zhangjinke/J-Link-OB-RA4M2/Photos/IMG_20231012_173926.jpg

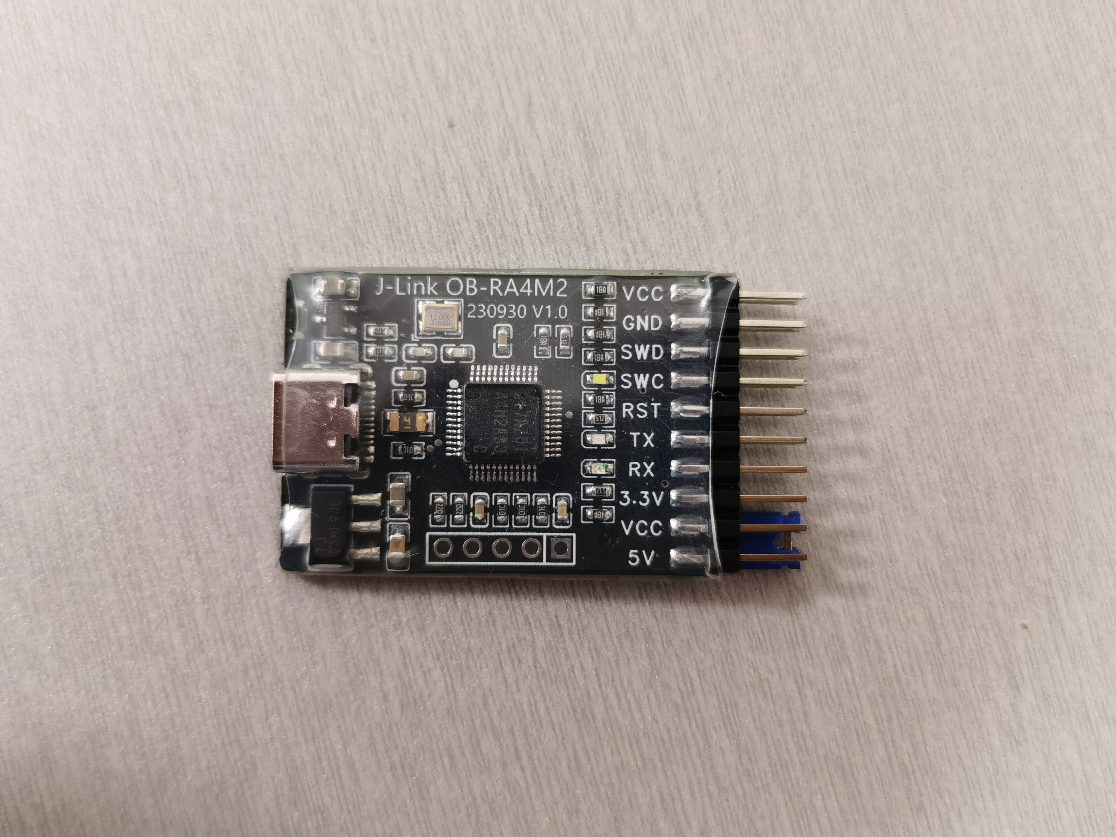
Photos/IMG_20231012_173926.jpg
