zhangjinke/J-Link-OB-RA4M2/README.md

# 简介
J-Link OB-RA4M2-Full
* 内核支持：Cortex-A、Cortex-M、Cortex-R、RISC-V (RV32, RV64)；
* 接口支持：JTAG、cJTAG、SWD、SWO（测试点方式引出）、1x virtual COM port (VCOM) + optional hardware flow control（测试点方式引出）；
* JTAG/SWD速度：4MHz；
* VCOM波特率：9600bps~1Mbps；
* 支持自动升级。
