zhangjinke/J-Link-OB-RA4M2/PCB/说明.txt

工程使用嘉立创EDA(专业版)创建

热缩管直径：Φ18mm
热缩管长度：42mm

当前版本TX、RX LED封装正负极反了，焊接的时候需要注意！
