zhangjinke/J-Link-OB-RA4M2/PCB/V1.0/BOM_Board1_J-Link OB-RA4M2_20230930_V1.0.xlsx

No. | Quantity | Comment | Designator | Footprint | Value | Manufacturer Part | Manufacturer | Primary Category | Secondary Category | LCSC Price | Price
1 | 4 | 10uF | C1,C2,C3,C4 | C0805 | 10uF | CL21A106KAYNNNE | SAMSUNG(三星) | 电容 | 贴片电容(MLCC) | 0.070966 | 0.283864
2 | 2 | 20pF | C5,C6 | C0603 | 20pF | CL10C200JB8NNNC | SAMSUNG(三星) |  |  | 0.043628 | 0.087256
3 | 4 | 100nF | C7,C8,C9,C10 | C0603 | 100nF | 0603B104K500NT | FH(风华) |  |  | 0.014054 | 0.056216
4 | 1 | 1N5819WS | D1 | SOD-323_L1.8-W1.3-LS2.5-RD |  | 1N5819WS | Hottech(合科泰) | 二极管 | 肖特基二极管 | 0.076238 | 0.076238
5 | 1 | BSMD1206-050-6V | F1 | F1206 |  | BSMD1206-050-6V | BHFUSE(佰宏) | TVS/保险丝/板级保护 | 自恢复保险丝 | 0.206758 | 0.206758
6 | 1 | WHITE | LED1 | LED0603-RD |  | WHITE | EVERLIGHT(亿光) |  |  | 0.212556 | 0.212556
7 | 1 | YELLOW | LED2 | LED0603-RD-YELLOW |  | YELLOW | EVERLIGHT(亿光) |  |  | 0.129957 | 0.129957
8 | 1 | BLUE | LED3 | LED0603-RD |  | BLUE | EVERLIGHT(亿光) |  |  | 0.173348 | 0.173348
9 | 1 | SWD | P1 | HDR-TH_5P-P2.54-V-M |  | SWD | XFCN(兴飞) | 连接器 | 排针 | 0.924 | 0.924
10 | 1 | PORT | P2 | HDR-SMD_20P-P2.54 |  | B-2100S20P-B110 | Ckmtw(灿科盟) | 连接器 | 排针 |  | 0
11 | 5 | 5.1kΩ | R1,R2,R10,R18,R19 | R0603 | 5.1kΩ | 0603WAF5101T5E | UNI-ROYAL(厚声) | 电阻 | 贴片电阻 | 0.006208 | 0.03104
12 | 2 | 27Ω | R3,R4 | R0603 | 27Ω | 0603WAF270JT5E | UNI-ROYAL(厚声) |  |  | 0.006254 | 0.012508
13 | 5 | 10kΩ | R5,R6,R7,R8,R9 | R0603 | 10kΩ | 0603WAF1002T5E | UNI-ROYAL(厚声) |  |  | 0.00548 | 0.0274
14 | 7 | 150Ω | R11,R12,R13,R14,R15,R16,R17 | R0603 | 150Ω | 0603WAF1500T5E | UNI-ROYAL(厚声) |  |  | 0.006217 | 0.043519
15 | 1 | ME6206A33XG | U1 | SOT-23-3_L2.9-W1.6-P1.90-LS2.8-BR |  | ME6206A33XG | MICRONE(南京微盟) | 电源芯片 | 线性稳压器(LDO) | 0.206451 | 0.206451
16 | 1 | TLV1117LV33DCYR | U2 | SOT-223_L6.7-W3.5-P2.30-BR |  | TLV1117LV33DCYR | TI(德州仪器) | 电源芯片 | 线性稳压器(LDO) | 0.7758 | 0.7758
17 | 1 | R7FA4M2AB3CFL#AA0 | U3 | LQFP-48_L7.0-W7.0-P0.50-LS9.0-BL |  | R7FA4M2AB3CFL#AA0 | RENESAS(瑞萨)/IDT | 单片机/微控制器 | 单片机(MCU/MPU/SOC) | 12 | 12
18 | 1 | KH-TYPE-C-16P | USB1 | USB-C-SMD_KH-TYPE-C-16P |  | KH-TYPE-C-16P | kinghelm(金航标) | Connectors | USB Connectors | 0.413 | 0.413
19 | 1 | 12MHz | X1 | OSC-SMD_4P-L3.2-W2.5-BL | 12MHz | X322512MSB4SI | YXC(扬兴晶振) | 晶振/振荡器/谐振器 | 无源晶振 | 0.307599 | 0.307599
 |  |  |  |  |  |  |  |  |  |  | 15.578514
