zhangjinke/J-Link-OB-RA4M2/PCB/V1.0/SCH_J-Link OB-RA4M2_20230930_V1.0.pdf

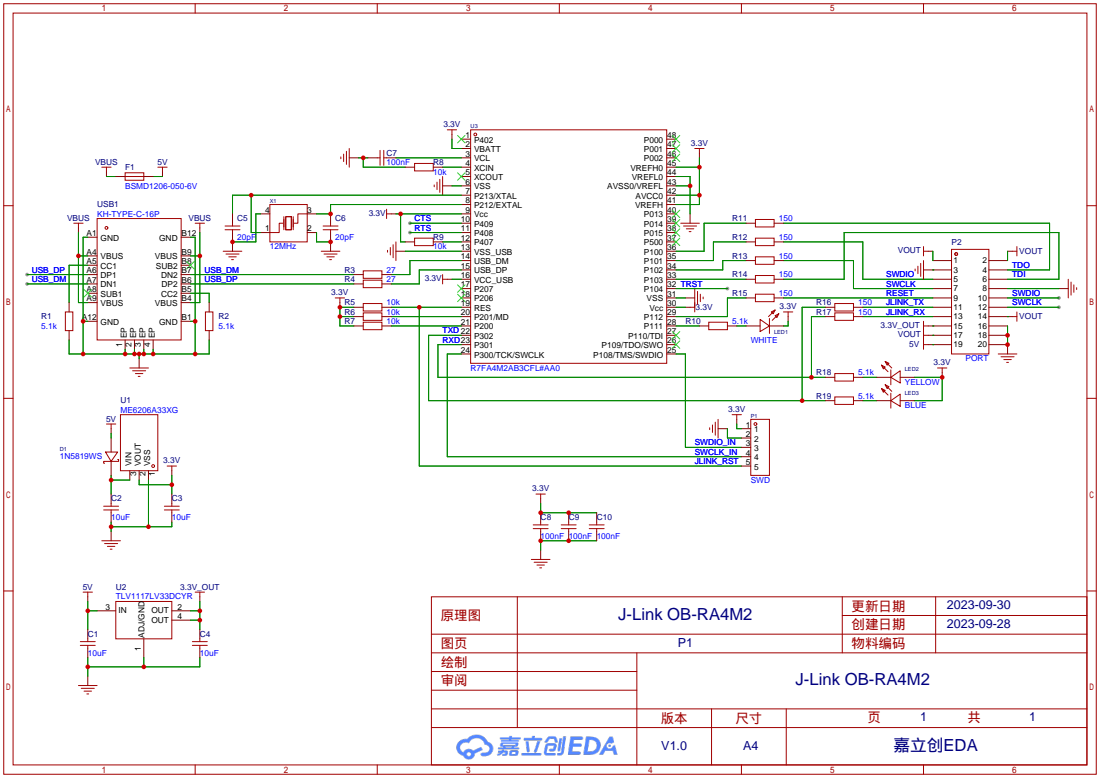
[picture p2: page 1]
