zhangjinke/J-Link-OB-RA4M2/(list of files, drawings)

Other design files:
PCB/V1.0/ProProject_J-Link OB-RA4M2_20230930_V1.0.epro
