zhangjinke/J-Link-OB-RA4M2/(threads)

Thread 2 (2023-10-14):

关于vcom

lizimu2020, 2023-10-14:
我的硬件是ra4m2adcfp（512KB 100PIN），jlink驱动识别正常，jtag和swd使用正常。但vcom串口在win的设备管理器里没有显示，是需要在哪里配置么？

zhangjinke, 2023-10-14:
VCOM需要使用J-Link Configurator使能后才能使用，具体可以查看https://wiki.segger.com/Using_J-Link_VCOM_functionality

lizimu2020, 2023-10-14:
开启成功，谢谢。

zhangjinke, 2023-10-14:
不客气

Closed 2023-10-14.
