zhangjinke/J-Link-OB-RA4M2/(commit log)

2023-10-12 增加实物照片
2023-10-18 增加支持自动升级的固件，并注明V1.0版PCB LED封装反了
2023-10-19 增加序列号范围描述
